husinthewei/PMTDIVIDER/README.md

# PMTDivider

A voltage divider board to power the Hamamatsu R9779 Photomultiplier Tube.
