husinthewei/PMTDIVIDER/Notes.txt

CSMD1210 voltage says 2k. Not actual sure what voltage rating should be.
