husinthewei/PMTDIVIDER/Voltage Divider Board Parts.xlsx

Part | Description | Rating | DigiKey Link | Unit Price (Cheaper when more) | Number (single board) | Comments
390k Resistor | RES SMD 390K OHM 5% 1/4W 1206 | 0.25W | https://www.digikey.com/product-detail/en/yageo/RC1206JR-07390KL/311-390KERCT-ND/732235 | $0.10 | 1
1.44M Resistor | RES SMD 1.43M OHM 1% 1/4W 1206 | 0.25W | https://www.digikey.com/product-detail/en/rohm-semiconductor/MCR18ERTF1434/RHM1.43MCJCT-ND/4085356 | $0.10 | 1 | Only found 1.43M
450k Resistor | RES SMD 453K OHM 1% 1/4W 1206 | 0.25W | https://www.digikey.com/product-detail/en/yageo/RC1206FR-07453KL/311-453KFRCT-ND/731872 | $0.10 | 2 | Only found 453k
300k Resistor | RES SMD 300K OHM 1% 1/4W 1206 | 0.25W | https://www.digikey.com/product-detail/en/yageo/RC1206FR-07300KL/311-300KFRCT-ND/731752 | $0.10 | 6
1M Resistor | RES SMD 1M OHM 5% 1/4W 1206 | 0.25W | https://www.digikey.com/product-detail/en/yageo/RC1206JR-071ML/311-1.0MERCT-ND/732134 | $0.10 | 1
51 Resistor | RES SMD 51 OHM 5% 1/4W 1206 | 0.25W | https://www.digikey.com/product-detail/en/yageo/RC1206JR-0751RL/311-51ERCT-ND/732259 | $0.10 | 3
0.022uF Cap | CAP CER 0.022UF 1.5KV X7R 1210 | 1.5KV | https://www.digikey.com/product-detail/en/kemet/C1210X223KFRACTU/399-10473-1-ND/4172926 | $0.86 | 3
Header | 14 Positions Header Connector 0.100" (2.54mm) Through Hole Gold |  | https://www.digikey.com/product-detail/en/3m/N2514-6002-RB/MHC14K-ND/755177 | $1.89 | 2 | Essentially exactly same as on current board. Alternative: https://www.digikey.com/product-detail/en/3m/2514-6002UB/MHB14K-ND/138388
