husinthewei/PMTDIVIDER/layoutmarkups/top.pdf

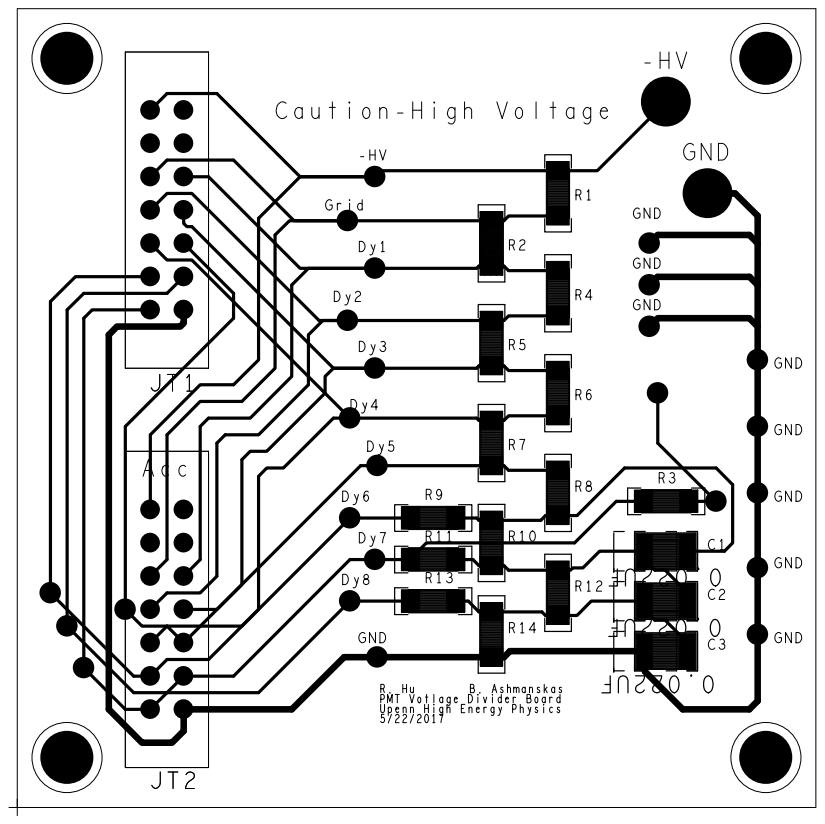
[picture p1: page 1]
