husinthewei/PMTDIVIDER/layoutmarkups/top_marked.pdf

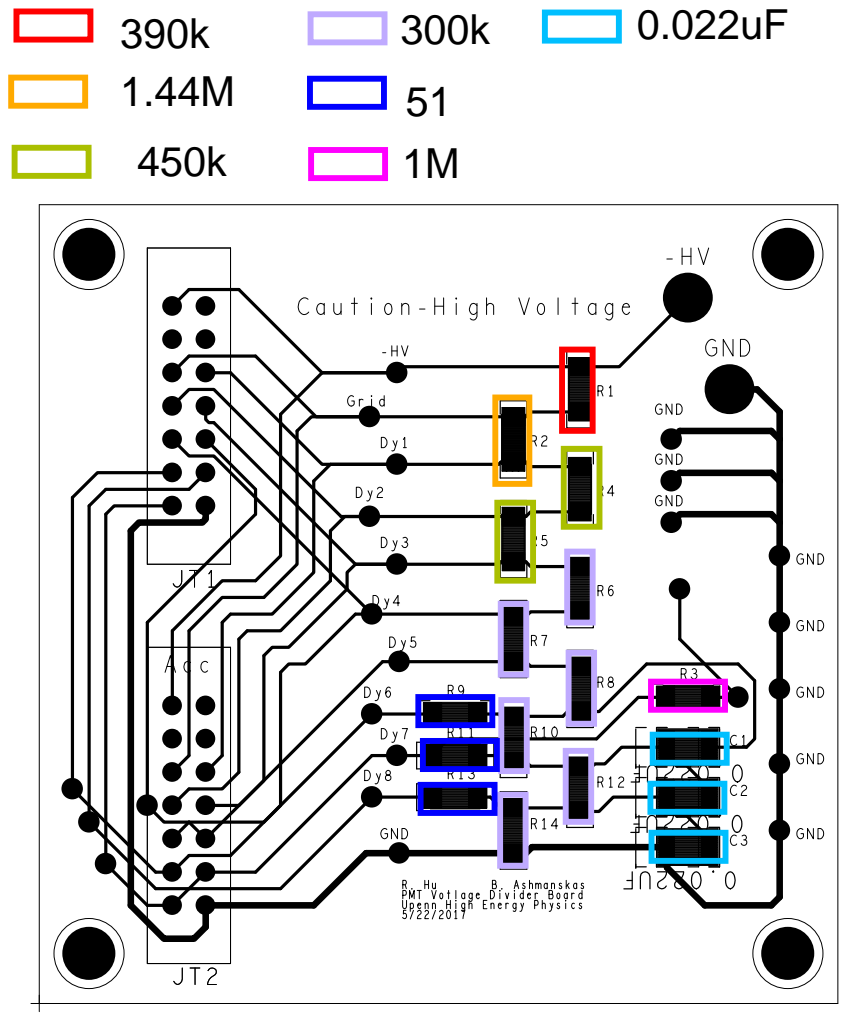
[picture p2: page 1]
