husinthewei/PMTDIVIDER/divider.asc

C1: cap; 0.022µ
C2: cap; 0.022µ
C3: cap; 0.022µ
R1: res; 390k
R2: res; 1440k
R3: res; 450k
R4: res; 450k
R5: res; 300k
R6: res; 300k
R7: res; 300k
R8: res; 300k
R9: res; 300k
R10: res; 300k
R11: res; 1000k
R12: res; 51
R13: res; 51
R14: res; 51
R15: res; 10000k
V1: voltage; 10
Named nets: 0
.tran 0 4mS 0
DY1
DY2
DY3
DY4
DY5
DY6
DY7
DY8
GRID
ACC
