husinthewei/PMTDIVIDER/Measurements.xlsx

 | Ratio | V (10Vin) | Simulation (10Vin) | Actual (10Vin) | Mounted Board Actual (10Vin) | Adjusted Mounted Board Actual (10Vin) | Expected(1200V) | High Voltage (1200V)
Grid | 4140/4530=0.9139 | 9.139 | 8.8245 | 8.794 | 8.801 | 8.799 | 1055.28 | 1120V
Dy1 | 2700/4530=0.5960 | 5.96 | 5.3741 | 5.344 | 5.351 | 5.344 | 641.28 | 836 (changing)
Dy2 | 2250/4530=0.4967 | 4.967 | 4.4616 | 4.426 | 4.436 | 4.428 | 531.12 | 740 (changing)
Dy3 | 1800/4530=0.3974 | 3.974 | 3.5847 | 3.55 | 3.566 | 3.558 | 426 | 640 (changing)
Dy4 | 1500/4530=0.3311 | 3.311 | 3.0093 | 2.984 | 2.992 | 2.986 | 358.08 | 581.5 (changing)
Dy5 | 1200/4530=0.2649 | 2.649 | 2.4342 | 2.413 | 2.43 | 2.418 | 289.56 | 508.6 (changing)
Dy6 | 900 /4530=0.1987 | 1.987 | 1.8531 | 1.841 | 1.855 | 1.84 | 220.92 | 443.6 (changing)
Dy7 | 600 /4530=0.1325 | 1.325 | 1.2589 | 1.252 | 1.267 | 1.252 | 150.24 | 381 (changing)
Dy8 | 300 /4530=0.0662 | 0.662 | 0.6642 | 0.644 | 0.6603 | 0.6453 | 77.28 | 319 (changing)
