husinthewei/PMTDIVIDER/(commit log)

2017-05-19 Set up Cadence project
    [expand.cfg, page1.csv]
2017-05-19 Working on layout
    [cases.cfg, divider.brd, expand.cfg, page1.csv]
2017-05-22 Finished rev 1
    [divider.brd, expand.cfg]
2017-05-23 Added many GND vias
    [divider.brd]
2017-05-26 Version 1 of dividers board
    [cases.cfg, divider.brd, divider_v1.brd, dividers.brd, dividers_v1.brd, expand.cfg, page1.csv]
2017-05-27 Almost finalized layout
    [art_param.txt, divider_v1.brd, dividers_v1.brd, dividers_v2.brd, nc_param.txt]
2017-06-23 Added expected dynode voltages
2017-06-27 Took some measurements
    [Measurements.xlsx, Voltage Divider Board Parts.xlsx]
2017-06-27 Did measurements at 1.2kV
    [Measurements.xlsx]
